Shiv-sp/Spatial-Mapping-System-LiDAR-/2DX3_FinalProject_pates302_code 3/Keil Code/i2c.c

#include <stdint.h>
#include "tm4c1294ncpdt.h"
#include "i2c.h"

#define I2C_MCS_ACK             0x00000008  // Data Acknowledge Enable
#define I2C_MCS_DATACK          0x00000008  // Acknowledge Data
#define I2C_MCS_ADRACK          0x00000004  // Acknowledge Address
#define I2C_MCS_STOP            0x00000004  // Generate STOP
#define I2C_MCS_START           0x00000002  // Generate START
#define I2C_MCS_ERROR           0x00000002  // Error
#define I2C_MCS_RUN             0x00000001  // I2C Master Enable
#define I2C_MCS_BUSY            0x00000001  // I2C Busy
#define I2C_MCR_MFE             0x00000010  // I2C Master Function Enable
#define MAXRETRIES              5           // number of receive attempts before giving up

void I2C_Init(void){
  SYSCTL_RCGCI2C_R |= SYSCTL_RCGCI2C_R0;           // activate I2C0
  SYSCTL_RCGCGPIO_R |= SYSCTL_RCGCGPIO_R1;          // activate port B
  while((SYSCTL_PRGPIO_R&0x0002) == 0){};// ready?

    GPIO_PORTB_AFSEL_R |= 0x0C;           // 3) enable alt funct on PB2,3       0b00001100
    GPIO_PORTB_ODR_R |= 0x08;             // 4) enable open drain on PB3 only

    GPIO_PORTB_DEN_R |= 0x0C;             // 5) enable digital I/O on PB2,3

  GPIO_PORTB_PCTL_R = (GPIO_PORTB_PCTL_R&0xFFFF00FF)+0x00002200;    //TED
    I2C0_MCR_R = I2C_MCR_MFE;                      // 9) master function enable
    I2C0_MTPR_R = 0b0000000000000101000000000111011;     // 8) configure for 100 kbps clock (added 8 clocks of glitch suppression ~50ns) 
}
