Shiv-sp/Spatial-Mapping-System-LiDAR-/2DX3_FinalProject_pates302_code 3/Keil Code/onboardLEDs.h

#include <stdbool.h>

void FlashLED1(int count);
void FlashLED2(int count);
void FlashLED3(int count);
void FlashLED4(int count);

void setLED(bool state);
void FlashAllLEDs(void);

void FlashI2CError(int count);
void FlashI2CTx(void);
void FlashI2CRx(void);

void onboardLEDs_Init(void);
